TheDIYGuy999/MPPT_Buck_Converter_ACS712/Schematic.pdf

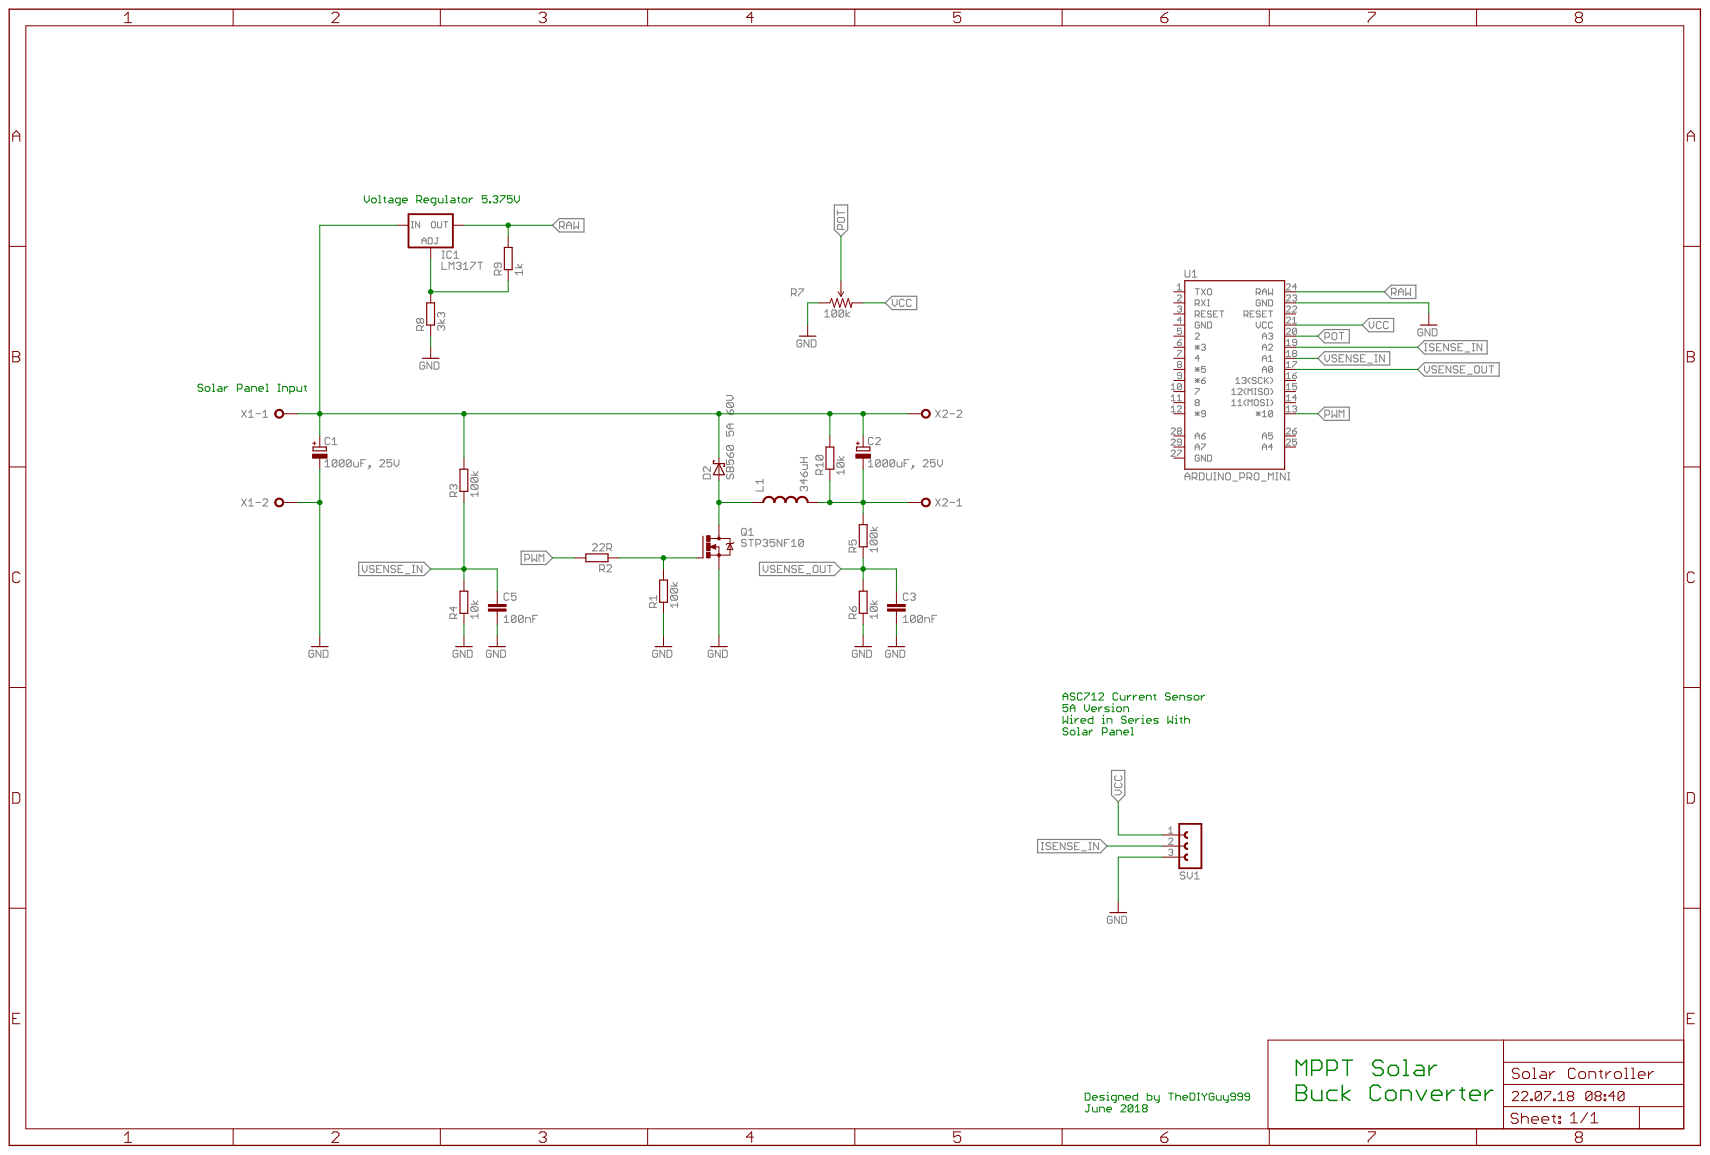
[picture p3: page 1]
