TheDIYGuy999/MPPT_Buck_Converter_ACS712/Solar Controller.pdf

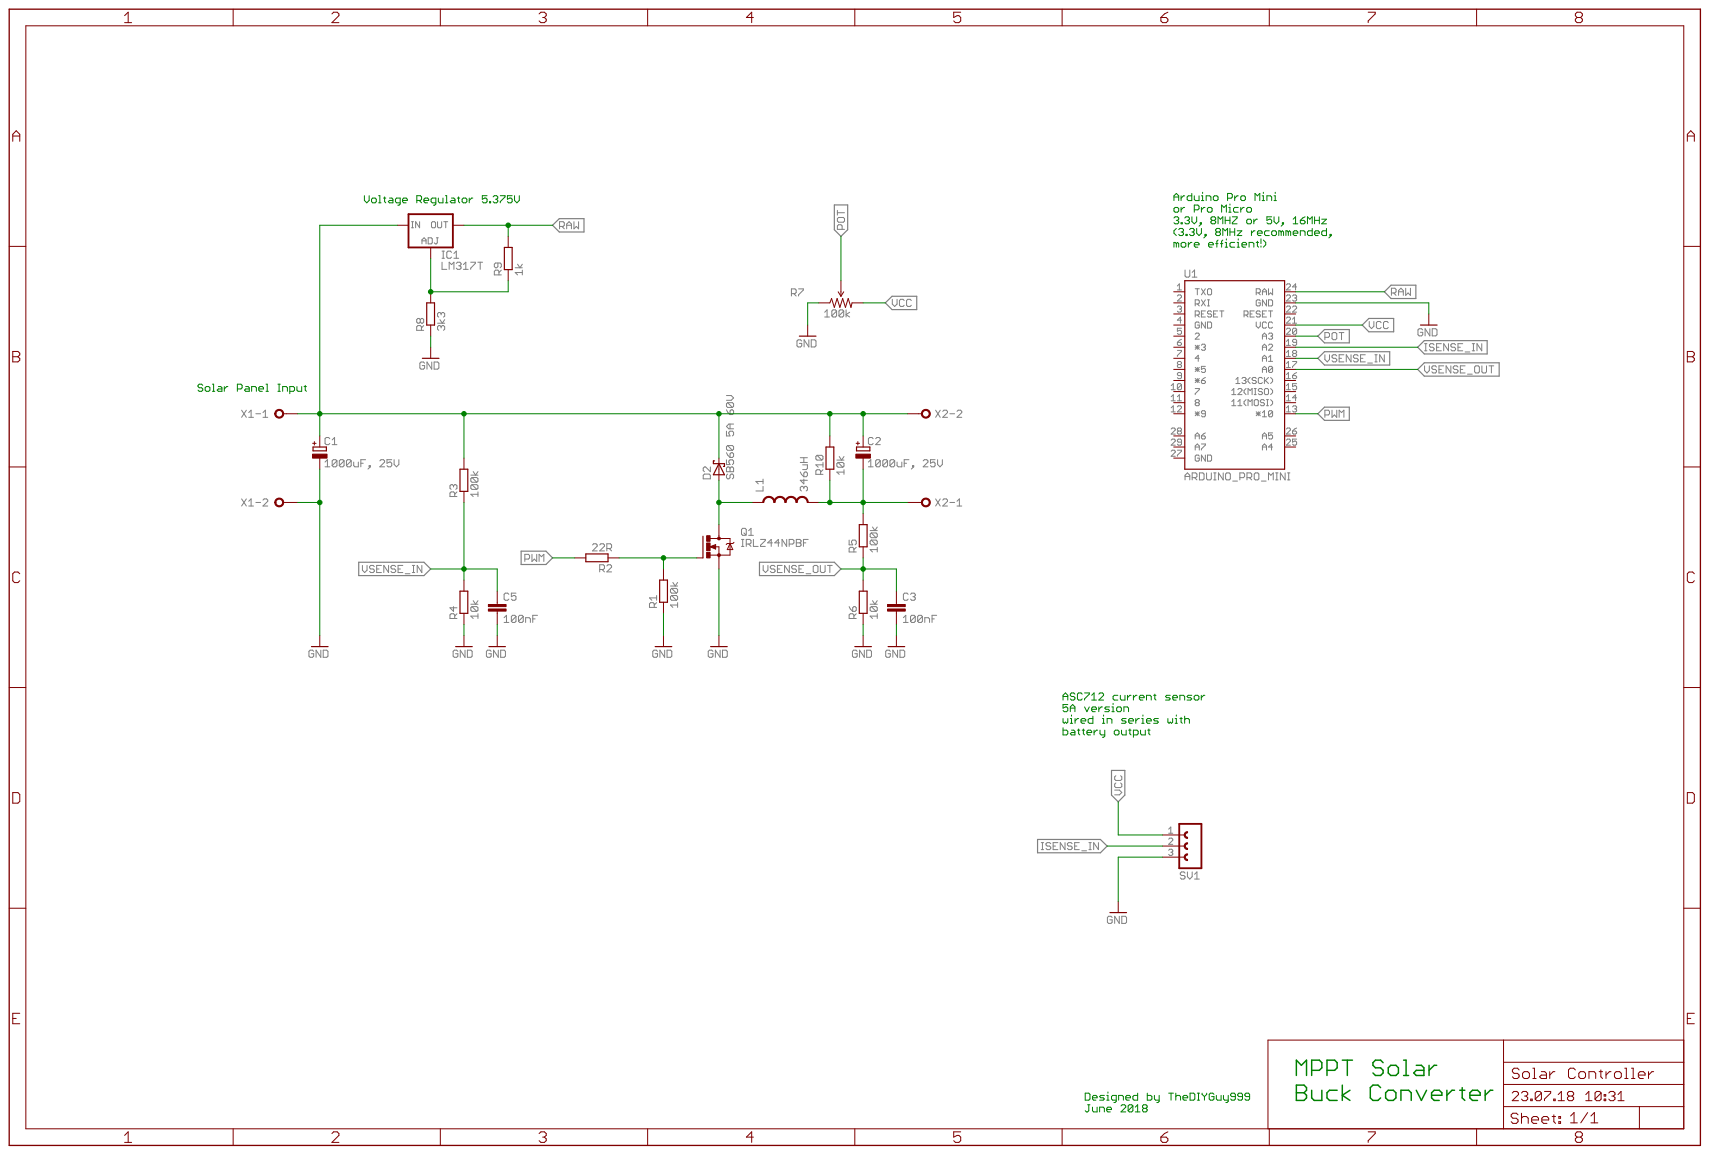
[picture p4: page 1]
