TheDIYGuy999/MPPT_Buck_Converter_ACS712/(commit log)

2018-06-19 V1.1: improved MPPT strategy, LED now also indicating operation mode
2018-07-08 V1.4: Constant Current mode added
2018-07-22 V1.5: Diode changed, current sensor moved
2018-07-23 V1.6: Mosfet changed, support for Atmega 328 added, 3.3V MCU recommended
2018-07-23 V1.61: inversed LED bug fixed on 328P (Pro Mini) platform
    [MPPT_Buck_Converter_ACS712.ino]
2018-07-25 V1.62: ACS712 scaling bug fixed for 3.3V MCU
    [MPPT_Buck_Converter_ACS712.ino]
